chakl/hackintosh-g5-cooler/doc/Block_Diagram.png

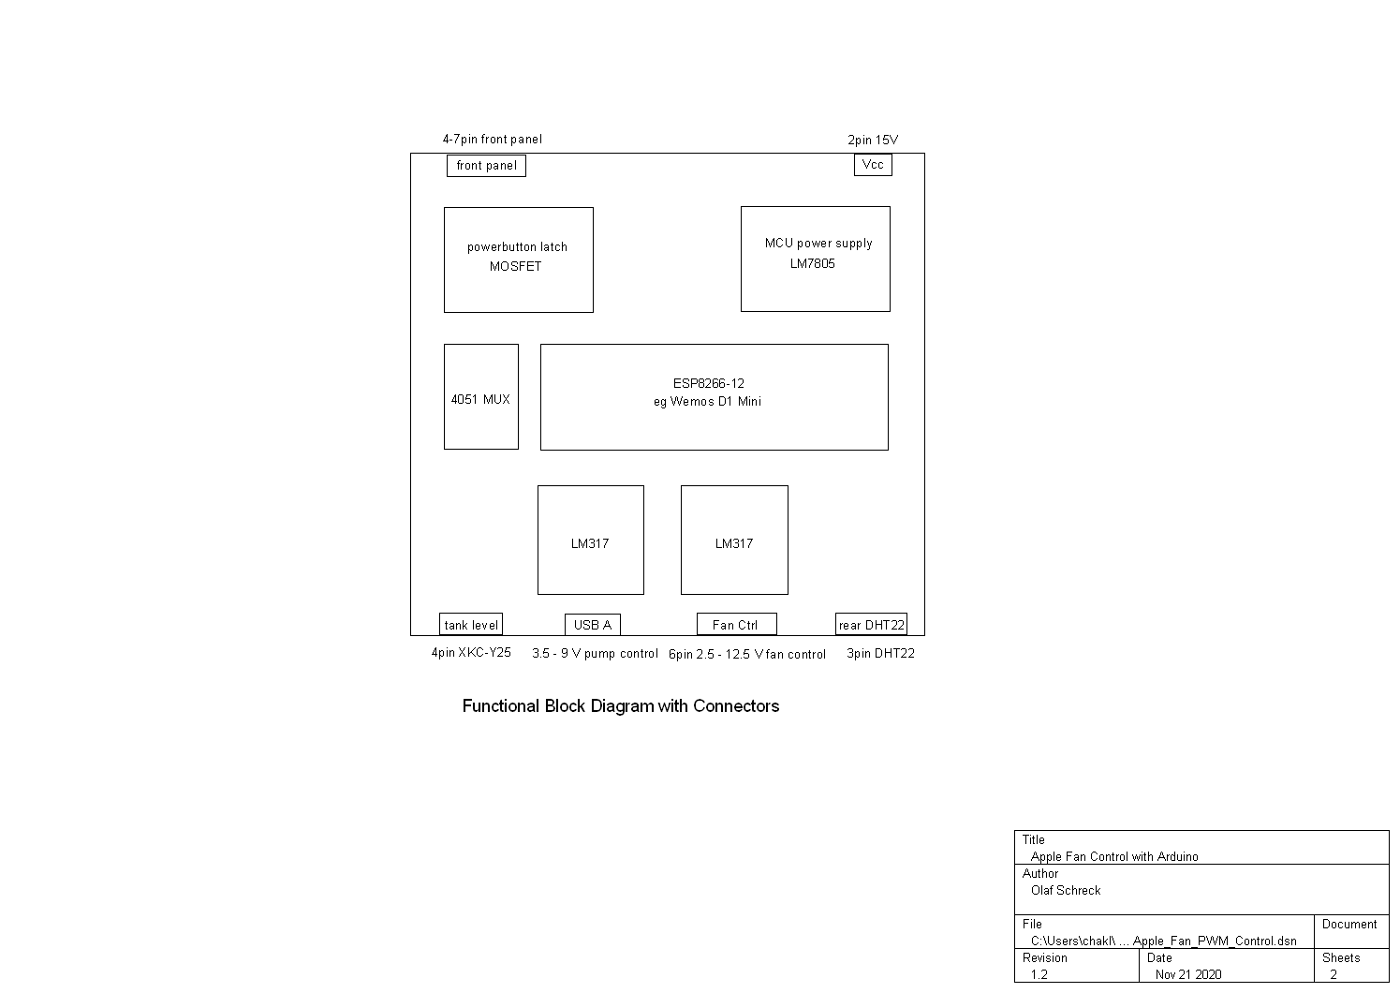
doc/Block_Diagram.png
