chakl/hackintosh-g5-cooler/doc/Pushbutton_Latch.png

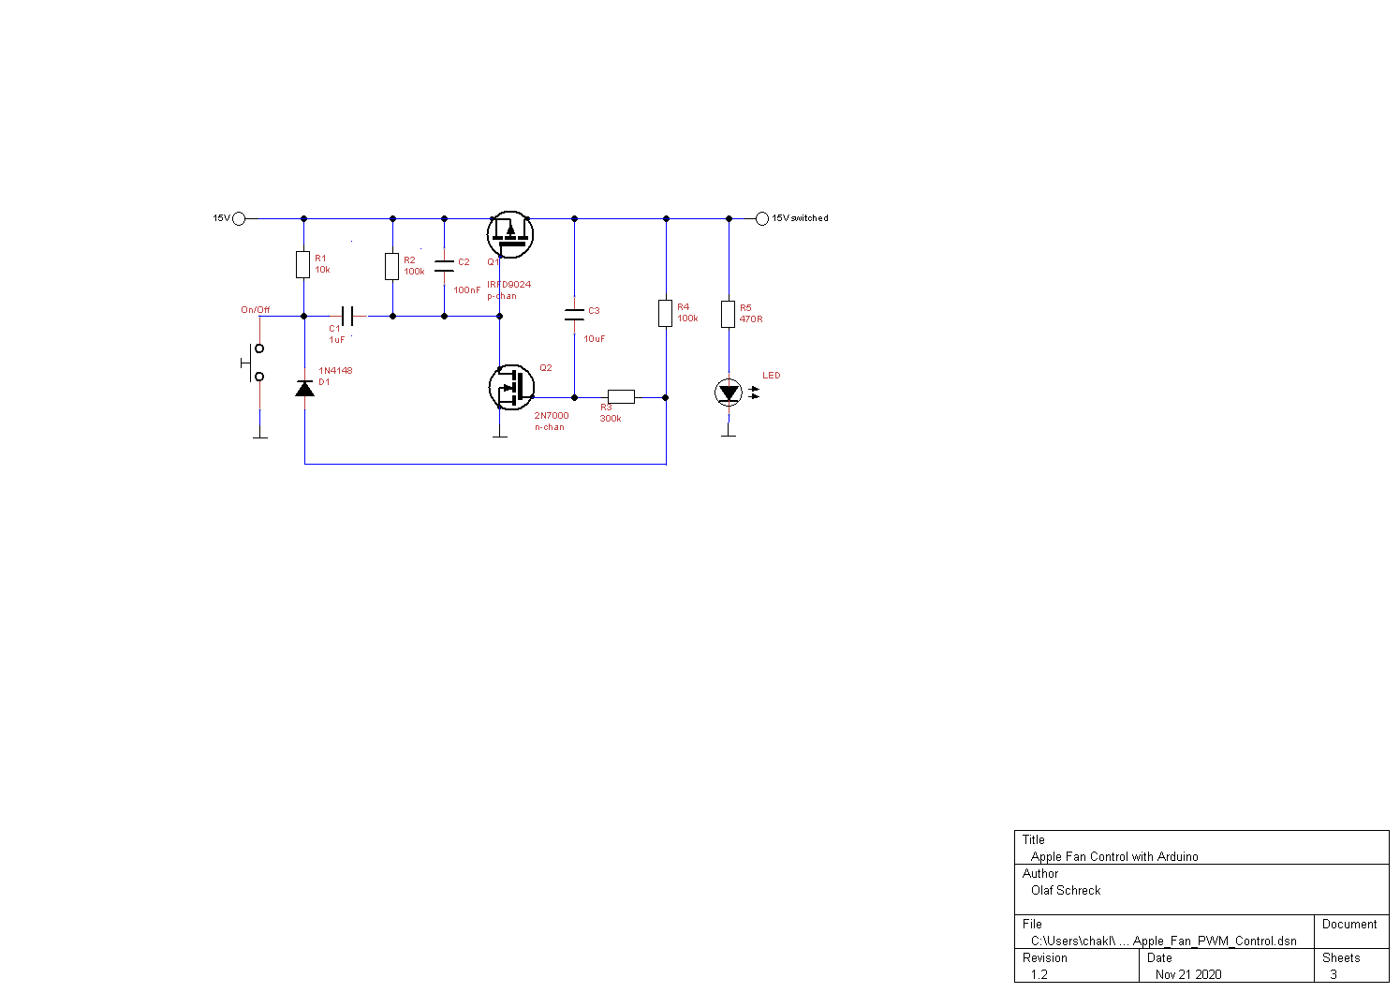
doc/Pushbutton_Latch.png
