chakl/hackintosh-g5-cooler/(list of files, drawings)

Other design files:
doc/Apple_Fan_PWM_Control.dsn
