chakl/hackintosh-g5-cooler/(commit log)

2020-11-15 add circuit schematics
    [Apple_Fan_PWM_Control.dsn]
2020-11-15 Inline circuit schematics
2020-11-19 notes on fans, front panel and MCU power supply
2020-11-20 [fix] symbols don't work in preprocessor == statements
    [config.h, hackintosh-g5-cooler.ino]
2020-11-20 [fix] force float in PWM value calculations
    [hackintosh-g5-cooler.ino]
2020-12-05 support front env sensor, g5 frontplate led, and bicolor led
2020-12-05 add pin requirements overview
2020-12-06 update schematics
    [Apple_Fan_PWM_Control.dsn]
2020-12-12 pushbutton LED not controlled by MCU
2020-12-13 first steps to support ESP32
2020-12-13 add stubs for AM2320 sensors and I2C
2020-12-13 implement I2C and AM2320 sensor support
2021-07-18 refactor hw defs; support voltage measuring; fixes and clarifications
    [config.h, credentials_default.h, hackintosh-g5-cooler.ino]
2021-07-18 fix compile error (dependency ordering)
    [config.h, hackintosh-g5-cooler.ino]
2021-07-22 [fix] add missing ifdef wrappers
    [hackintosh-g5-cooler.ino]
2021-07-22 [fix] add missing comment
    [config.h]
2021-07-22 [fix] change naming scheme for component constants (confĺict with ADS1115 lib)
    [config.h, hackintosh-g5-cooler.ino]
2021-07-22 [fix] typo in chip name
    [config.h, hackintosh-g5-cooler.ino]
2021-07-23 [fix] add missing ifdef wrapper
    [hackintosh-g5-cooler.ino]
2021-07-23 [fix] wifi features only if WITH_ESP8266_WIFI
    [config.h]
2021-07-23 [improve] add pump pwm reporting
2021-07-24 [fix] Wire.begin() for HW_ARDUINO
    [hackintosh-g5-cooler.ino]
2021-07-30 revert use of SerialDebug, use consolePrintln()
    [hackintosh-g5-cooler.ino]
2021-08-01 [feature] water tank sensor
2021-08-01 [fix] display active SSID, not the intended one
    [hackintosh-g5-cooler.ino]
2021-08-01 [doc] deprecate Arduino MCUs
